VdiVictor/KiCAD_Lib/3D_Models/Connectors/XT30PW-F.step

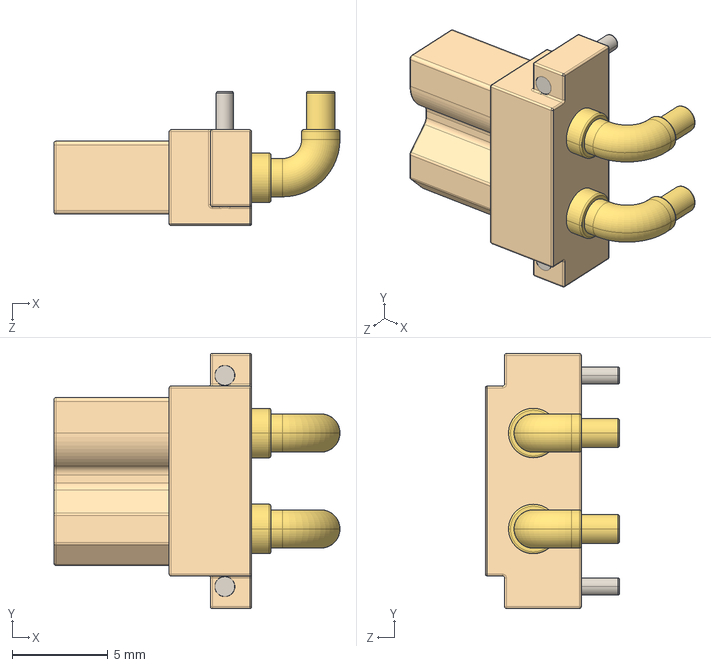
[picture p1: CAD file, 2023-06-27]
3D_Models/Connectors/XT30PW-F.step
14.9 x 13.3 x 7.00 mm
