VdiVictor/KiCAD_Lib/3D_Models/ICs/DFN_PLP_2730-12_NMD.step

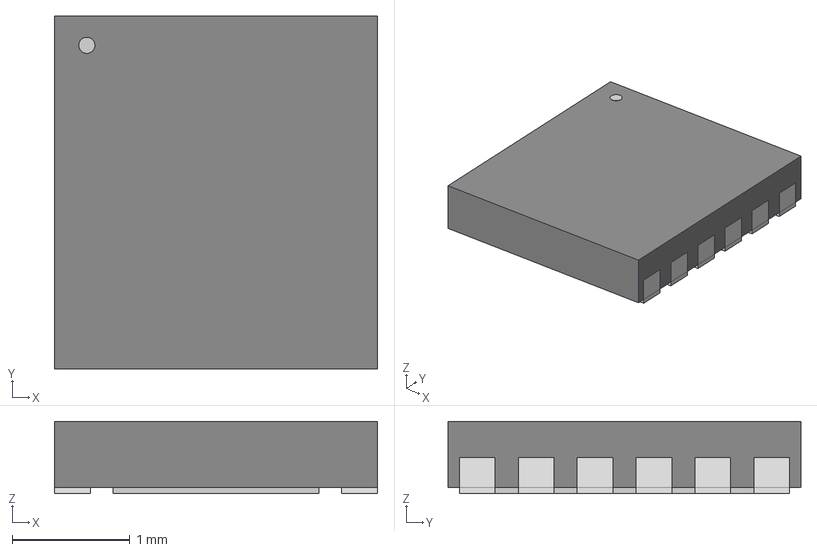
[picture p2: CAD file, 2023-03-18]
3D_Models/ICs/DFN_PLP_2730-12_NMD.step
2.74 x 3.00 x 0.612 mm
