VdiVictor/KiCAD_Lib/3D_Models/Modules/LoRa-E5-HF_3D_File.stp

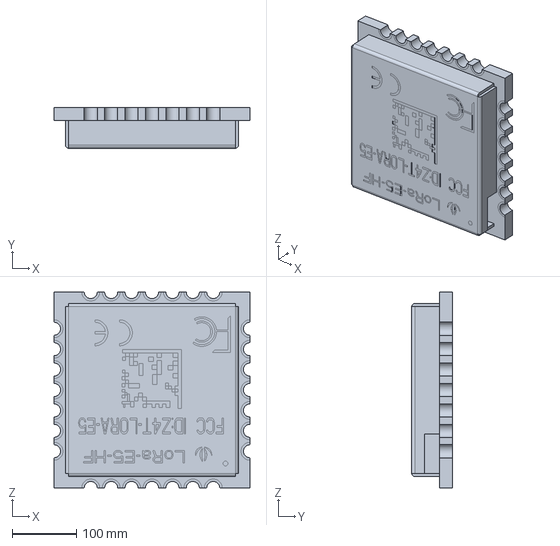
[picture p3: CAD file, 2022-05-01]
3D_Models/Modules/LoRa-E5-HF_3D_File.stp
304.8 x 63.8 x 304.8 mm
