VdiVictor/KiCAD_Lib/3D_Models/Oscillators/X_3.2x1.5x0.9mm.STEP

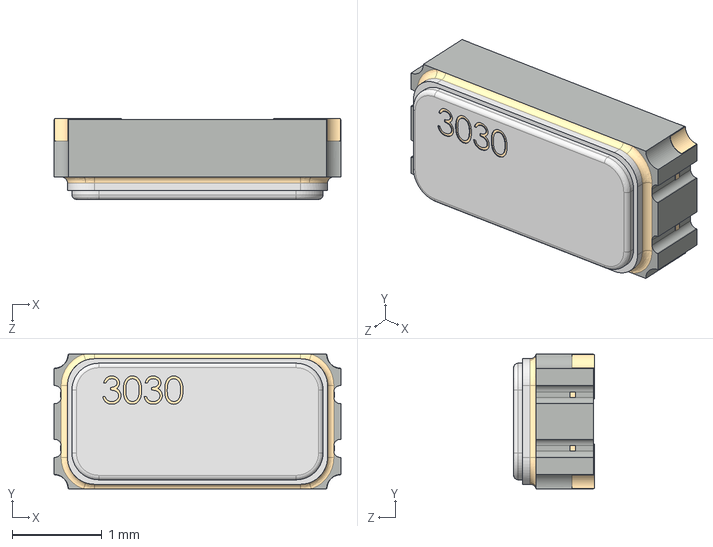
[picture p4: CAD file, 2023-03-07]
3D_Models/Oscillators/X_3.2x1.5x0.9mm.STEP
3.20 x 1.50 x 0.9 mm
