VdiVictor/KiCAD_Lib/3D_Models/Passives/Capacitors/CapAluRadial_D100H250.STEP

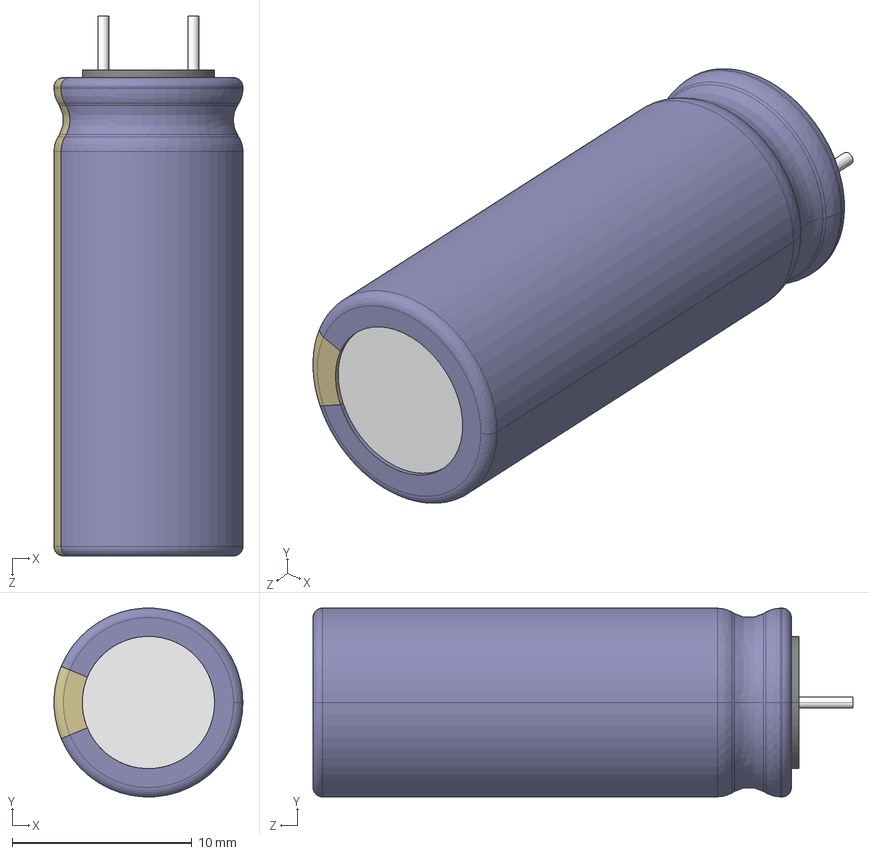
[picture p5: CAD file, 2022-10-31]
3D_Models/Passives/Capacitors/CapAluRadial_D100H250.STEP
10.5 x 10.5 x 30.0 mm
rubber_pad
can
shell_and_minus
shell_and_minus_2
lead x 2
