VdiVictor/KiCAD_Lib/3D_Models/Passives/Diodes/AXGD10603NR.STEP

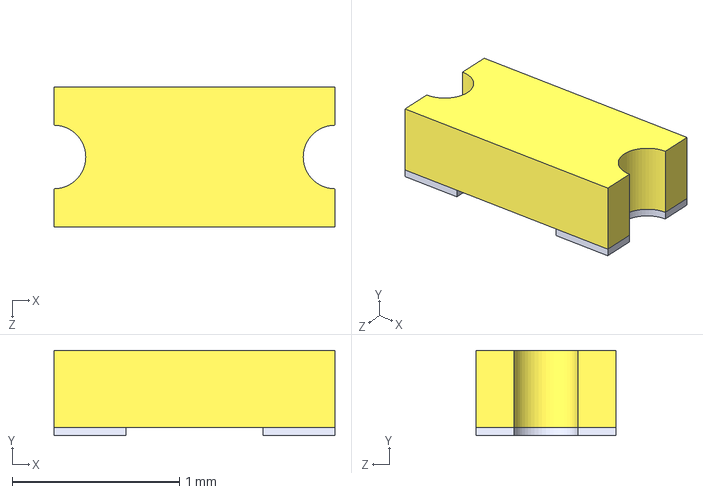
[picture p6: CAD file, 2023-04-28]
3D_Models/Passives/Diodes/AXGD10603NR.STEP
1.68 x 0.51 x 0.84 mm
