VdiVictor/KiCAD_Lib/3D_Models/Passives/Resistors/TC33X.STEP

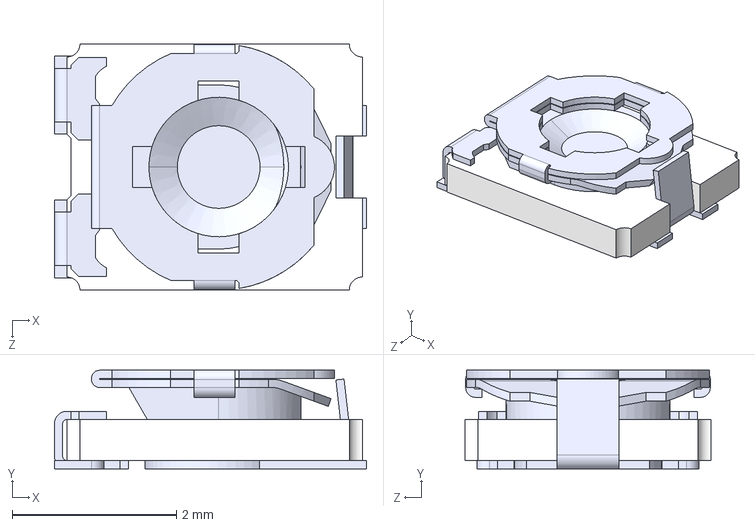
[picture p7: CAD file, 2023-04-16]
3D_Models/Passives/Resistors/TC33X.STEP
3.80 x 1.20 x 3.00 mm
