VdiVictor/KiCAD_Lib/3D_Models/Switches/WE_4351x10148xx(rev1).stp

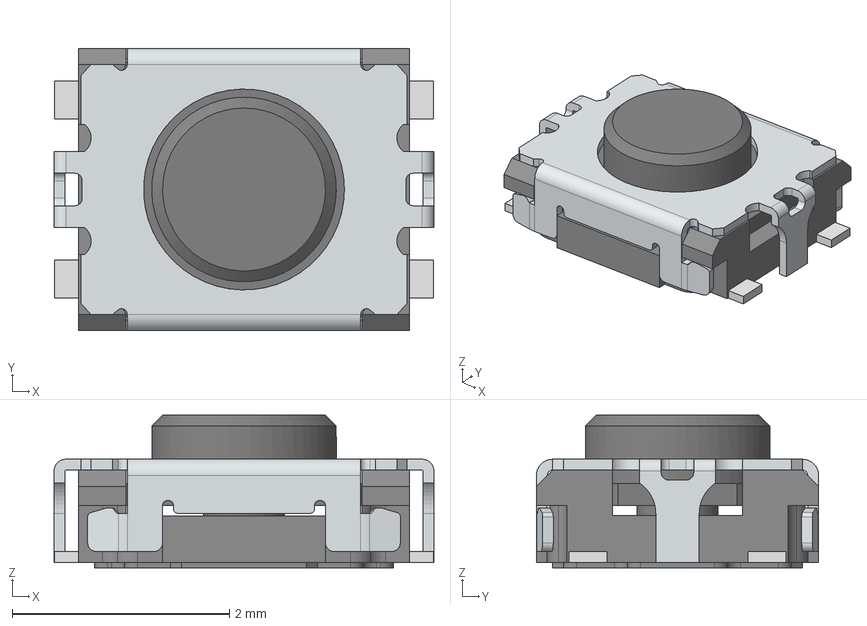
[picture p8: CAD file, 2023-04-12]
3D_Models/Switches/WE_4351x10148xx(rev1).stp
3.50 x 2.60 x 1.40 mm
Base
Stem
Frame
Pin x 4
