VdiVictor/KiCAD_Lib/3D_Models/Transformers/Coilcraft-WBC1-1L_.step

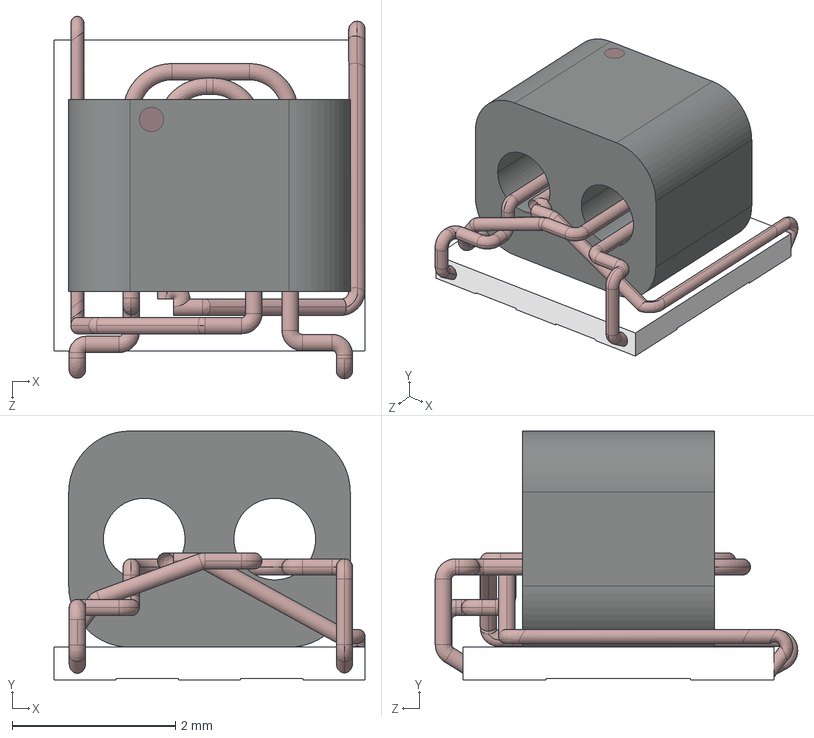
[picture p9: CAD file, 2023-07-23]
3D_Models/Transformers/Coilcraft-WBC1-1L_.step
3.81 x 3.05 x 4.44 mm
