VdiVictor/KiCAD_Lib/3D_Models/Connectors/SMA-J-P-H-ST-EM3.stp

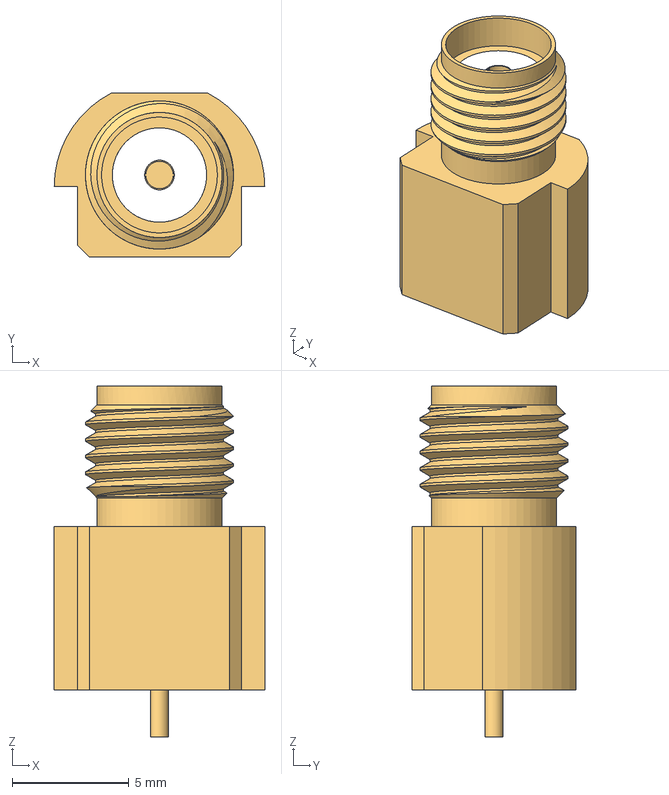
[picture p10: CAD file, 2023-03-07]
3D_Models/Connectors/SMA-J-P-H-ST-EM3.stp
9.00 x 7.00 x 15.0 mm
60312202114307_Shelding
60312202114307_insulator
60312202114307_Signalpin
