VdiVictor/KiCAD_Lib/3D_Models/ICs/DHVQFN-14.step

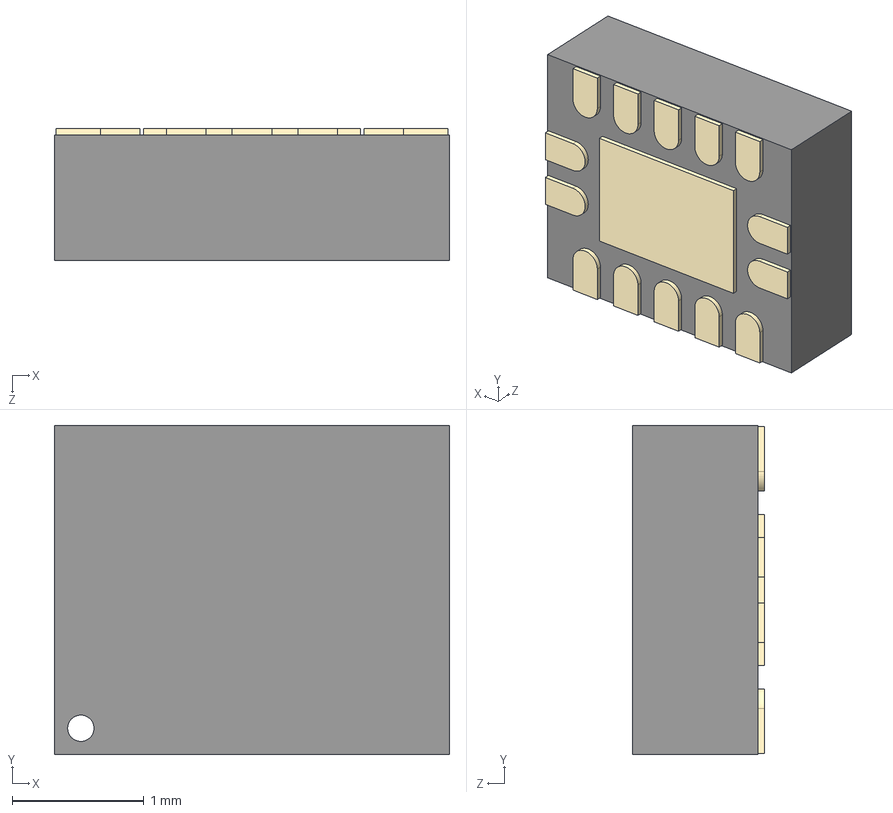
[picture p11: CAD file, 2023-03-07]
3D_Models/ICs/DHVQFN-14.step
3.00 x 2.50 x 1.00 mm
