VdiVictor/KiCAD_Lib/3D_Models/Oscillators/X_3.2x2.5x0.8mm.STEP

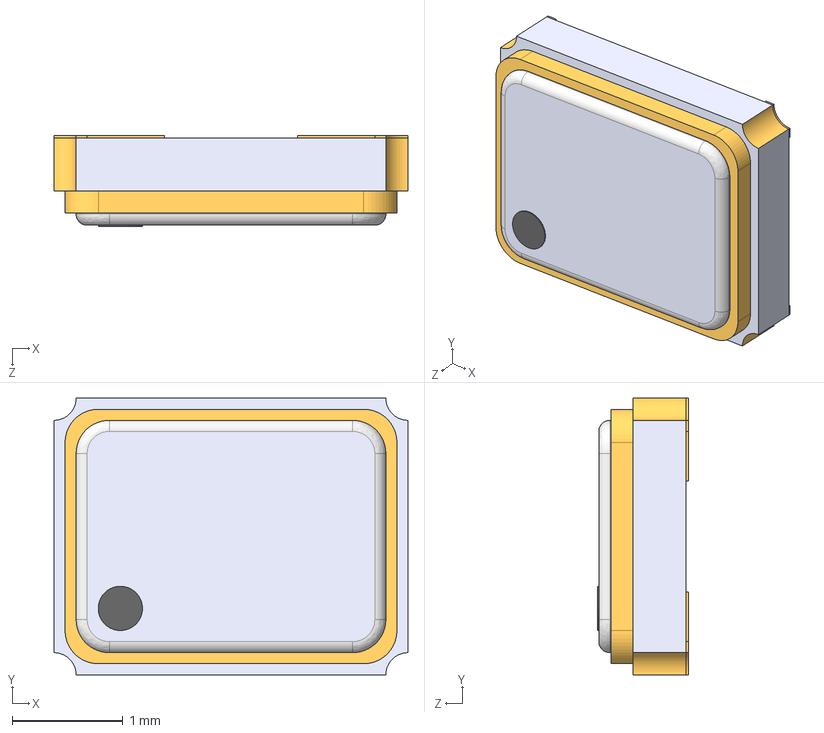
[picture p12: CAD file, 2022-04-30]
3D_Models/Oscillators/X_3.2x2.5x0.8mm.STEP
3.20 x 2.50 x 0.82 mm
MetalFrame
Pin1Marker
Pin3
Pin1
Lid
Pin4
Pin2
Ceramic
