VdiVictor/KiCAD_Lib/3D_Models/Passives/Diodes/PowerDI5.STEP

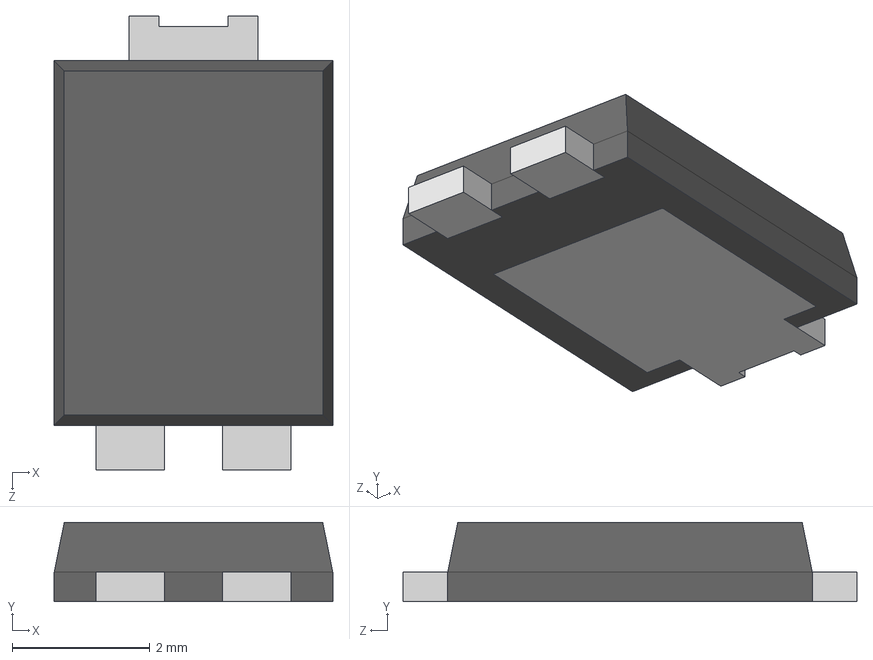
[picture p13: CAD file, 2022-10-31]
3D_Models/Passives/Diodes/PowerDI5.STEP
4.05 x 1.15 x 6.60 mm
