VdiVictor/KiCAD_Lib/3D_Models/Connectors/DCJ200-10-A-K1-K.stp

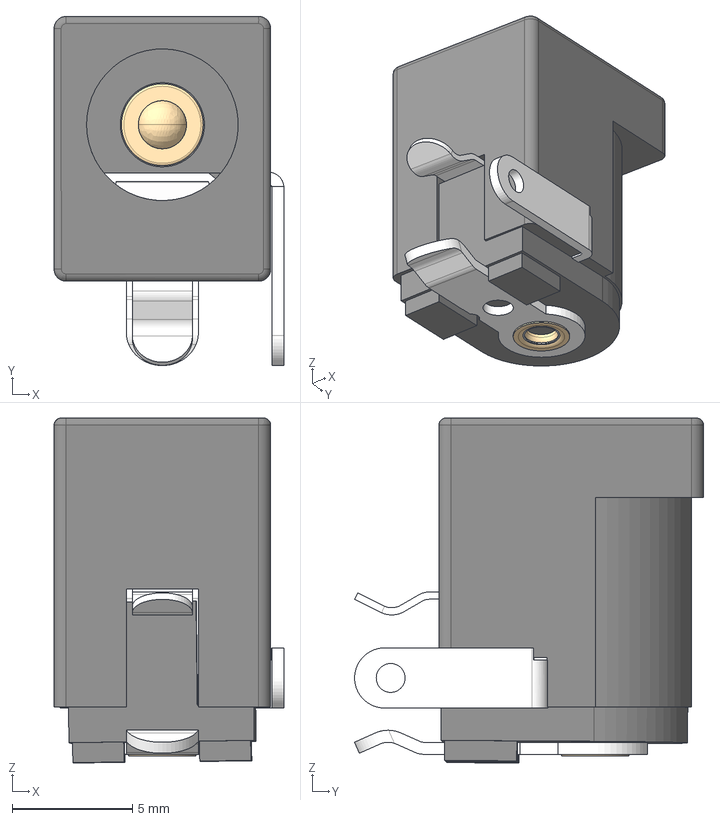
[picture p14: CAD file, 2022-10-31]
3D_Models/Connectors/DCJ200-10-A-K1-K.stp
9.55 x 14.5 x 14.3 mm
DCJ200-10-A-K1-K_PART6
DCJ200-10-A-K1-K_PART5
DCJ200-10-A-K1-K_PART4
DCJ200-10-A-K1-K_PART3
DCJ200-10-A-K1-K_PART2
DCJ200-10-A-K1-K_PART1
