VdiVictor/KiCAD_Lib/3D_Models/ICs/SOIC8_3.9x4.9.step

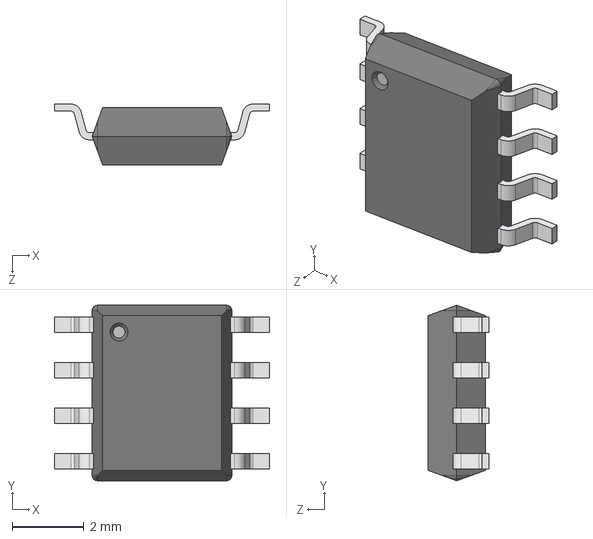
[picture p15: CAD file, 2023-03-07]
3D_Models/ICs/SOIC8_3.9x4.9.step
6.00 x 4.90 x 1.70 mm
