VdiVictor/KiCAD_Lib/3D_Models/Connectors/USB4515-GF-A.stp

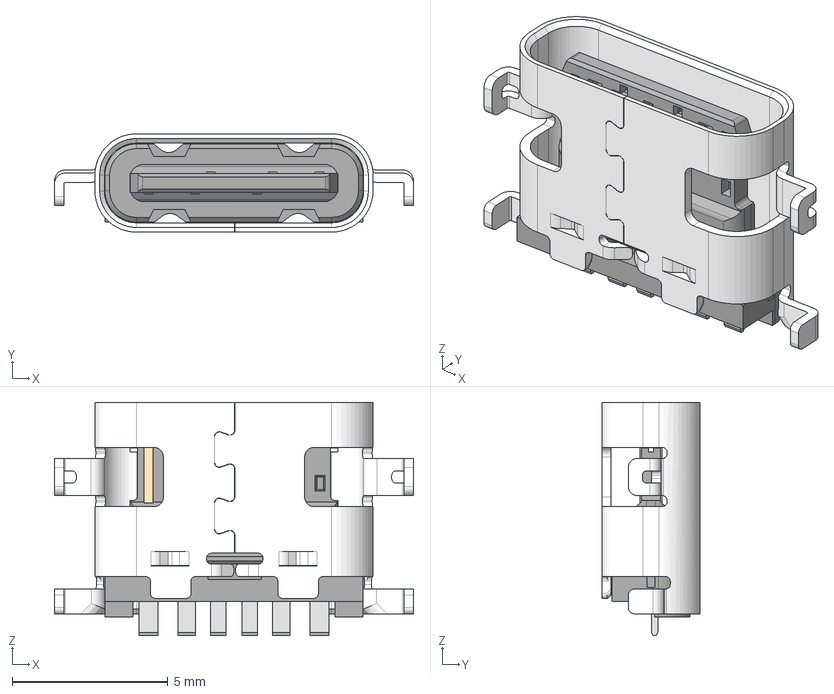
[picture p16: CAD file, 2022-05-01]
3D_Models/Connectors/USB4515-GF-A.stp
11.5 x 3.16 x 7.50 mm
Imported1
Move Face1
