VdiVictor/KiCAD_Lib/3D_Models/ICs/SO-8.STEP

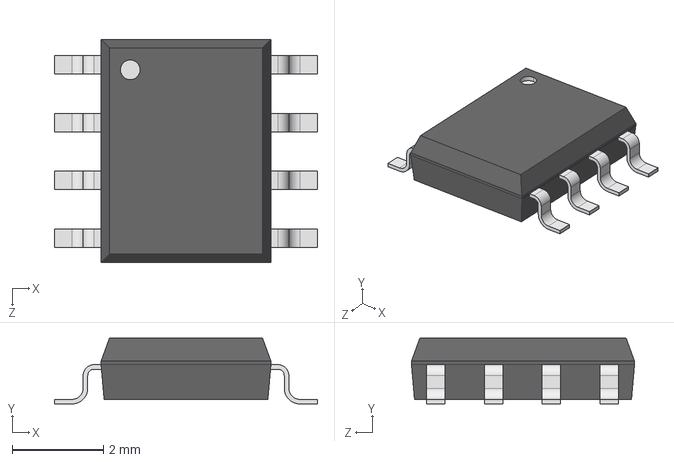
[picture p17: CAD file, 2023-01-21]
3D_Models/ICs/SO-8.STEP
5.78 x 1.45 x 4.90 mm
