VdiVictor/KiCAD_Lib/3D_Models/Connectors/USB4510-03-1-A.stp

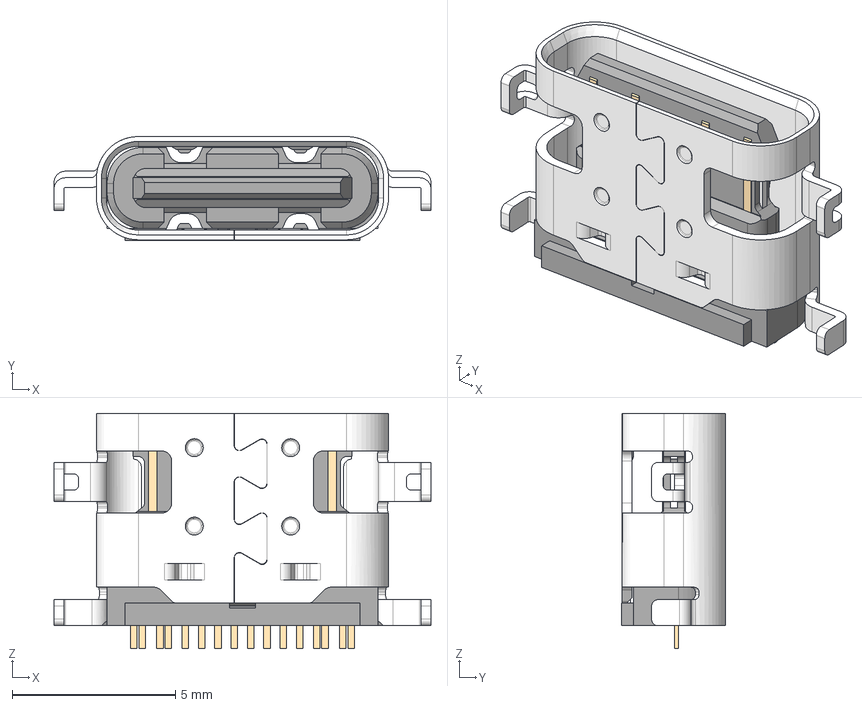
[picture p18: CAD file, 2022-04-30]
3D_Models/Connectors/USB4510-03-1-A.stp
11.5 x 3.18 x 7.20 mm
