VdiVictor/KiCAD_Lib/3D_Models/ICs/SOIC8_Wide_5mmx5mm.STEP

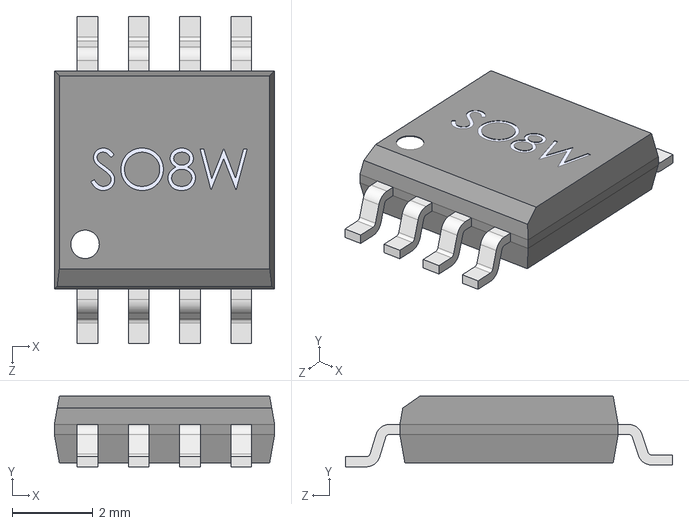
[picture p19: CAD file, 2022-04-30]
3D_Models/ICs/SOIC8_Wide_5mmx5mm.STEP
5.46 x 1.75 x 8.10 mm
