VdiVictor/KiCAD_Lib/(commit log)

2022-03-21 Few resistors
2022-04-30 Add of 3D models
    [SOIC8_Wide_5mmx5mm.STEP, USB4510-03-1-A.stp, X_3.2x2.5x0.8mm.STEP]
2022-05-01 Ajout de modules
    [LoRa-E5-HF_3D_File.stp, USB4515-GF-A.stp]
2022-10-31 Ajout de composants
2023-01-21 New components&footprints
    [SO-8.STEP]
2023-01-22 Creation of new LED and TP libs
2023-01-24 New resistors
2023-03-07 Creation of new 74xx series lib & new components/footprints/3D models
    [DHVQFN-14.step, SMA-J-P-H-ST-EM3.stp, SOIC8_3.9x4.9.step, X_3.2x1.5x0.9mm.STEP]
2023-03-18 New components
    [DFN_PLP_2730-12_NMD.step]
2023-04-08 Ajout de nouveaux composants
2023-04-12 New components and creation of switches
    [WE_4351x10148xx(rev1).stp]
2023-05-19 Modification de certaines empreintes et symboles
2023-06-27 Changed 99_Misc to 99_Mechanical, and new components
    [XT30PW-F.step]
