VdiVictor/KiCAD_Lib/(notices)

Notices in the files:
3D_Models/Connectors/DCJ200-10-A-K1-K.stp:
author */ ('License CC BY-ND 4.0'),
3D_Models/Connectors/USB4515-GF-A.stp:
FILE_NAME( 'p:/temp/worker_101/temp/exporttempdir_3084_1070_8QtUT/format_0/USB4515-GF-A.stp', '2022-05-01T07:22:04', ( 'License CC BY-ND 4.0' ), ( 'CADENAS' ), ' ', 'PARTsolutions', ' ' );
3D_Models/Connectors/USB4510-03-1-A.stp:
FILE_NAME( 'p:/temp/worker_39/temp/exporttempdir_3976_65_MrxuO/format_0/USB4510-03-1-A.stp', '2022-02-19T04:00:37', ( 'License CC BY-ND 4.0' ), ( 'CADENAS' ), ' ', 'PARTsolutions', ' ' );
